hancockks/OpenSCAD_case/case_library.scad

// case_library.scad
// Parametric case/box library — plain OpenSCAD, no external includes (see hinge include below
// for the one exception: it pulls in ../OpenSCAD_hinge/hinge_library.scad, tagged so
// OpenSCAD-gui can auto-fetch it too).
//
// @github: morganp/OpenSCAD_hinge
include <../OpenSCAD_hinge/hinge_library.scad>

// ---------------------------------------------------------------------------
// Internal helpers
// ---------------------------------------------------------------------------

module _rounded_rect(l, w, r, fn=48) {
    rr = min(r, l/2, w/2);
    hull() {
        for (cx = [rr, l-rr]) for (cy = [rr, w-rr])
            translate([cx, cy]) circle(r=rr, $fn=fn);
    }
}

module _box_shell(length, width, height, wall, corner_r, fn) {
    difference() {
        linear_extrude(height=height) _rounded_rect(length, width, corner_r, fn);
        translate([wall, wall, wall])
            linear_extrude(height=height + 0.1) // extra overshoot avoids coplanar Boolean artifacts
                _rounded_rect(length - 2*wall, width - 2*wall, max(0.1, corner_r - wall), fn);
    }
}

module _dividers(length, width, height, wall, div_x, div_y, div_thickness) {
    inner_l = length - 2*wall;
    inner_w = width  - 2*wall;
    div_h   = height - wall - 0.1; // stop just below the rim to avoid coplanar skins
    if (div_x > 0) {
        step = inner_l / (div_x + 1);
        for (i = [1:div_x])
            translate([wall + step*i - div_thickness/2, wall, wall])
                cube([div_thickness, inner_w, div_h]);
    }
    if (div_y > 0) {
        step = inner_w / (div_y + 1);
        for (i = [1:div_y])
            translate([wall, wall + step*i - div_thickness/2, wall])
                cube([inner_l, div_thickness, div_h]);
    }
}

// Matching lid ribs close the headspace above body dividers so small parts cannot migrate.
// They overlap the lid floor by 0.1 mm for a robust union and leave div_gap at the seam.
// Keep a small clearance from the rebated front and side walls. The hinge-side ends
// meet the full-thickness inner wall because there is no latch rebate there.
module _lid_dividers(length, width, hb, hl, wall, div_x, div_y, div_thickness,
                     div_gap=0.2, edge_clearance=0.4) {
    inner_l = length - 2*wall;
    inner_w = width  - 2*wall;
    rib_l   = inner_l - 2*edge_clearance;
    rib_w   = inner_w - edge_clearance;
    rib_h   = max(0, hl - wall - div_gap + 0.1);
    z0      = hb + div_gap;
    if (div_x > 0) {
        step = inner_l / (div_x + 1);
        for (i = [1:div_x])
            translate([wall + step*i - div_thickness/2, wall + edge_clearance, z0])
                cube([div_thickness, rib_w, rib_h]);
    }
    if (div_y > 0) {
        step = inner_w / (div_y + 1);
        for (i = [1:div_y])
            translate([wall + edge_clearance, wall + step*i - div_thickness/2, z0])
                cube([rib_l, div_thickness, rib_h]);
    }
}

// 45-degree chamfer cutter along the back edge at y=w, z=z: a diamond prism whose
// cross-section is centered on the edge line, so subtracting it from either the body
// (solid below/inside) or the lid (solid above/inside) chamfers that part's rim edge.
module _hb_edge_chamfer(l, w, z, ch) {
    s = ch * 1.4143;
    translate([-1, w, z])
        rotate([45, 0, 0])
            translate([0, -s/2, -s/2])
                cube([l + 2, s, s]);
}

// Alignment/dust lip: the inner portion of the body wall carried up past the seam, flush
// with the wall's inner face — a shiplap joint with the rebated lid wall, so the lip is
// solid wall material, not a separate ring. Cut short of the back edge so nothing sits
// inside the hinge swing zone.
module _hb_lip(l, w, wall, lip_t, z, lip_h, y_max, corner_r, fn) {
    o = wall - lip_t;
    intersection() {
        translate([0, 0, z - 0.5]) // overlaps the wall top so lip and wall fuse
            linear_extrude(height=lip_h + 0.5)
                difference() {
                    translate([o, o])
                        _rounded_rect(l - 2*o, w - 2*o, max(0.1, corner_r - o), fn);
                    translate([wall, wall])
                        _rounded_rect(l - 2*wall, w - 2*wall,
                                      max(0.1, corner_r - wall), fn);
                }
        translate([-1, -1, z - 1]) cube([l + 2, y_max + 1, lip_h + 3]);
    }
}

// Snap ridge on the lip's front outer face: square bottom face retains the closed lid,
// chamfered top face cams the lid wall outward as it slides down over the lip.
module _hb_bump(l, wall, lip_t, z, lip_h, latch_w, latch_bump) {
    bh = max(0.6, min(3, lip_h - 1.2));
    z0 = z + max(0.6, (lip_h - bh)/2);
    yo = wall - lip_t; // lip outer face
    hull() {
        translate([l/2 - latch_w/2, yo - 0.01, z0])
            cube([latch_w, 0.02, bh]);
        translate([l/2 - latch_w/2, yo - latch_bump, z0])
            cube([latch_w, latch_bump, max(0.4, bh - latch_bump*1.5)]);
    }
}

// Body tray in closed-assembly coordinates: tub + dividers + lip + snap ridge + front ribs.
module _hb_body(l, w, hb, wall, corner_r, div_x, div_y, div_t,
                lip_h, lip_t, c, lip_ymax, latch_w, latch_bump,
                rib_xs, rib_w, rib_d, back_ch, fn) {
    difference() {
        union() {
            _box_shell(l, w, hb, wall, corner_r, fn);
            _dividers(l, w, hb, wall, div_x, div_y, div_t);
            _hb_lip(l, w, wall, lip_t, hb, lip_h, lip_ymax, corner_r, fn);
            _hb_bump(l, wall, lip_t, hb, lip_h, latch_w, latch_bump);
            for (x = rib_xs)
                translate([x - rib_w/2, -rib_d, 0])
                    cube([rib_w, rib_d + 0.01, hb - 0.2]);
        }
        if (back_ch > 0)
            _hb_edge_chamfer(l, w, hb, back_ch);
    }
}

// Lid tray in closed-assembly coordinates (opening down, spanning z in [hb, hb+hl]):
// shell + lip rebate + front/top ribs + latch groove + lid text + hinge-clearance chamfer.
module _hb_lid(l, w, hb, hl, wall, corner_r, c, lip_t, lip_ymax,
               lip_h, latch_w, latch_bump,
               div_x, div_y, div_t, div_gap, div_clearance,
               rib_xs, rib_w, rib_d, back_ch,
               txt, txt_size, txt_depth, txt_emboss, fn) {
    top   = hb + hl;
    bh    = max(0.6, min(3, lip_h - 1.2));
    z0    = hb + max(0.6, (lip_h - bh)/2);
    y_reb = wall - lip_t - c;   // rebated inner face over the lip engagement zone
    gd    = latch_bump - c;     // groove depth into the rebated wall
    difference() {
        union() {
            translate([0, 0, hb])
                difference() {
                    linear_extrude(height=hl) _rounded_rect(l, w, corner_r, fn);
                    translate([wall, wall, -0.05])
                        linear_extrude(height=hl - wall + 0.05)
                            _rounded_rect(l - 2*wall, w - 2*wall,
                                          max(0.1, corner_r - wall), fn);
                }
            for (x = rib_xs) {
                translate([x - rib_w/2, -rib_d, hb + 0.2])
                    cube([rib_w, rib_d + 0.01, hl - 0.2]);
                translate([x - rib_w/2, -rib_d, top - 0.01])
                    cube([rib_w, rib_d + w - 2, rib_d + 0.01]);
            }
            if (txt_emboss && len(txt) > 0)
                translate([l/2, w/2, top - 0.01])
                    linear_extrude(height=txt_depth + 0.01)
                        text(txt, size=txt_size, halign="center", valign="center");
        }
        // rebate: thin the lid wall's inner portion over the lip engagement zone so the
        // body's wall-lip slides up inside it (shiplap seam); restricted to where the lip
        // exists so the back wall around the hinge straps keeps full thickness
        intersection() {
            translate([0, 0, hb - 0.05])
                linear_extrude(height=lip_h + c + 0.15)
                    translate([y_reb, y_reb])
                        _rounded_rect(l - 2*y_reb, w - 2*y_reb,
                                      max(0.1, corner_r - y_reb), fn);
            translate([-1, -1, hb - 1])
                cube([l + 2, lip_ymax + c + 1.4, lip_h + c + 2]);
        }
        // latch groove in the rebated front wall face, mating the lip's snap ridge
        translate([l/2 - latch_w/2 - 0.3, y_reb - gd, z0 - 0.2])
            cube([latch_w + 0.6, gd + 0.01, bh + 0.5]);
        if (!txt_emboss && len(txt) > 0)
            translate([l/2, w/2, top - txt_depth])
                linear_extrude(height=txt_depth + 0.02)
                    text(txt, size=txt_size, halign="center", valign="center");
        if (back_ch > 0)
            _hb_edge_chamfer(l, w, hb, back_ch);
    }
    // Add after the rebate/groove cuts so the containment ribs keep their full height.
    _lid_dividers(l, w, hb, hl, wall, div_x, div_y, div_t, div_gap, div_clearance);
}

// Hinge leaves along the back seam, in closed-assembly coordinates. The hinge modules
// generate flat at Z=0 with the axis along Y; this reorients them so the mount plane lands
// at mount_y (the back face minus the recess depth, so the leaf plates sit inside the
// walls, outer face flush), the axis runs along X at the seam height, leaf2 straps into
// the body (below the seam) and leaf1 into the lid (above it).
module _hb_hinges(type, xs, mount_y, hb, len_each, leaf_w, strap_w, kod, cod,
                  pin, pin_c, leaf_t, parts, fn) {
    for (x = xs)
        translate([x, mount_y, hb])
            rotate([-90, 0, 0])
                rotate([0, 0, 90]) {
                    if (type == "crate")
                        crate_hinge(leaf_length=len_each, strap_width=strap_w,
                                    strap_thickness=leaf_t,
                                    knuckle_od=cod, knuckle_count=3, axis_height=0,
                                    pin_d=pin, pin_clearance=pin_c, knuckle_gap=0.4,
                                    screws_per_leaf=0, print_pin=false, parts=parts, fn=fn);
                    else if (type == "flush") {
                        // odd knuckle count at ~8mm pitch, like piano_hinge, so the
                        // lid leaf owns both end knuckles and the pin stays captive
                        raw = max(3, round(len_each / 8));
                        flush_knuckle_hinge(leaf_length=len_each, leaf_width=leaf_w,
                                            knuckle_od=kod,
                                            knuckle_count=raw % 2 == 0 ? raw + 1 : raw,
                                            pin_d=pin, pin_clearance=pin_c,
                                            knuckle_gap=0.3, scallop_clearance=0.3,
                                            integral_pin=false, print_pin=false,
                                            parts=parts, fn=fn);
                    }
                    else if (type == "piano")
                        piano_hinge(length=len_each, leaf_width=leaf_w, leaf_thickness=leaf_t,
                                    knuckle_od=kod, pin_d=pin, pin_clearance=pin_c,
                                    integral_pin=false, print_pin=false, parts=parts, fn=fn);
                    else
                        knuckle_hinge(leaf_length=len_each, leaf_width=leaf_w,
                                      leaf_thickness=leaf_t, knuckle_od=kod, knuckle_count=5,
                                      pin_d=pin, pin_clearance=pin_c, knuckle_gap=0.3,
                                      integral_pin=false, print_pin=false, parts=parts, fn=fn);
                }
}

// Cylinder(s) along the hinge axis, one per hinge span: used both as the knuckle relief
// notch cut from the mating rims (r = barrel radius + clearance) and as the top-level pin
// bore (r = pin radius + clearance) cut after the leaves are unioned in, so wall material
// never refills the embedded back half of the bore.
module _hb_axis_cyl(xs, len_each, y, z, r, fn) {
    if (r > 0)
        for (x = xs)
            translate([x - len_each/2 - 0.5, y, z])
                rotate([0, 90, 0])
                    cylinder(h=len_each + 1, r=r, $fn=fn);
}

// ---------------------------------------------------------------------------
// hinged_box — two-tray hinged box: body tray + lid tray joined by pinned hinges
// across the back seam, snap latch on the front.
//
// Two printed parts (body upright, lid beside it opening up), no supports. Each part
// carries its own fused hinge leaf; drop in the pin to assemble. Piano/knuckle hinges
// take a length of 1.75mm filament as the pin, the crate hinge takes a 4mm rod or the
// printed pins emitted next to the parts.
//
// hinge_type:
//   "piano"   — one continuous knuckle hinge across the back seam (default; robust,
//               even load spread, filament pin).
//   "knuckle" — hinge_count discrete knuckle hinges (lighter, classic look).
//   "crate"   — chunky raised-lug crate hinges for the rugged/ammo-box look; pair with
//               ribs > 0. Lid opens past 180 degrees.
//   "flush"   — fully hidden hinge (flush_knuckle_hinge): pivot centered inside the back
//               wall, knuckle OD equals the wall thickness, zero protrusion; works down to
//               2mm walls. The leaf plates are full wall thickness and run right up to the
//               axis, with a scallop along each inner edge nesting the other leaf's
//               knuckles, so the lid opens flat to 180 degrees (closes flat, folds flat).
//               Pin is a 0.8mm rod/wire slid in along the
//               seam from past the left corner (the axis line runs through open air behind
//               the corner rounding, so no tunnel is needed); a plug fused inside the far
//               knuckle makes that end blind, and a small printed cap glues into the first
//               knuckle's bore to close the entry — both coaxial, so the swing never sees
//               them. A cove relief along the seam lets the rims swing past the buried axis.
//
// An alignment lip on the body rim registers the closed lid; a snap ridge on the lip's
// front face clicks into a groove inside the lid wall. Clearances are a best-effort
// starting point — verify fit and tune lid_clearance / latch_bump for your printer.
//
// Origin: box centered on the XY origin, base at Z=0, hinge on the +Y edge (per this
// repo's conventions). pose="closed" previews the assembled box for fit checks.
// ---------------------------------------------------------------------------
module hinged_box(
    length          = 120,
    width           = 80,
    height          = 40,     // body tray OUTER height, bed to seam, includes the floor wall
    lid_depth       = 15,     // lid tray OUTER height above the seam, includes the lid top wall
    wall            = 2.4,
    corner_r        = 6,
    div_x           = 0,
    div_y           = 0,
    lid_dividers    = false,  // true = matching ribs under the lid to retain small parts
    lid_divider_clearance = 0.4, // clearance at rebated front/side walls; hinge side stays flush
    div_thickness   = 1.6,
    hinge_type      = "piano", // "piano" | "knuckle" | "crate"
    hinge_count     = 2,      // knuckle/crate: number of discrete hinges
    hinge_len       = 30,     // knuckle/crate: leaf length along X per hinge
    hinge_margin    = 8,      // hinge inset from each end along X
    knuckle_od      = 0,      // piano/knuckle barrel OD; 0 = auto (max(5, 2*wall))
    pin_d           = 0,      // hinge pin dia; 0 = auto (1.75 filament, 4 for crate)
    pin_clearance   = 0.25,
    leaf_thickness  = 2,      // hinge leaf/strap thickness, recessed into the back walls
                              // (clamped to wall - 0.4 so the leaf stays inside the wall)
    lip_h           = 4,      // alignment lip height above the seam
    lid_clearance   = 0.3,    // radial clearance between lip and lid inner wall
    latch_w         = 14,     // width of the snap latch, centered on the front
    latch_bump      = 0.8,    // snap ridge protrusion from the lip face
    ribs            = 0,      // rugged-look vertical ribs on the front + over the lid top
    rib_w           = 0,      // rib width; 0 = auto (2.5*wall)
    rib_depth       = 0,      // rib protrusion; 0 = auto (wall)
    lid_text        = "",
    lid_text_size   = 10,
    lid_text_depth  = 0.6,
    lid_text_emboss = false,  // true = raised (prints face-down: prefer deboss on FDM)
    pose            = "print", // "print" = both parts flat on the bed | "closed" = assembled
    fn              = 48
) {
    l = length; w = width; hb = height; hl = lid_depth; t = wall; c = lid_clearance;
    lid_div_x = lid_dividers ? div_x : 0;
    lid_div_y = lid_dividers ? div_y : 0;
    crate = hinge_type == "crate";
    flush = hinge_type == "flush";
    kod   = flush ? t : (knuckle_od > 0 ? knuckle_od : max(5, 2*t));
    cod   = 9;                                    // crate barrel OD
    pin   = pin_d > 0 ? pin_d
          : flush ? 0.8                           // 0.8mm rod/wire, works down to 2mm walls
          : crate ? 4 : 1.75;
    pinc  = flush ? min(pin_clearance, 0.15) : pin_clearance; // thin flush knuckles need a
                                                  // snugger bore to keep any skin around it
    edge  = crate ? cod/2 + 0.4 : kod/2 + 0.3;    // barrel-to-strap edge, per hinge module
    leaf_te = min(leaf_thickness, t - 0.4);       // recessed leaf thickness; the flush hinge
                                                  // ignores it (its plates are kod thick)
    leafw = flush ? max(t, min(10, hl - 0.4))     // flush plate: axis to outer edge, embeds
                                                  // full-depth in the back wall
          : max(1.5, min(10, hl - edge - 0.4));   // piano/knuckle leaf width, fits lid wall
    strapw = max(3, min(16, hl - edge - 0.4));    // crate strap width, fits lid wall
    ch    = (crate || flush) ? 0 : 0.8; // rim chamfer to clear the low external piano barrel
    lip_t = min(1, t/2);      // lip = inner portion of the wall: max 1mm or 50% of the wall
    lb    = min(latch_bump, c + max(0.2, t - lip_t - c - 0.4)); // clamp the snap ridge so its
                              // groove leaves >=0.4 skin in the rebated lid wall
    lip_he = max(0.8, min(lip_h, hl - t - c - 0.2)); // lip + rebate fit inside the lid cavity
    lip_ymax = w - t - c - (lip_he + 2*t);        // keep the lip out of the hinge swing zone
    rw    = rib_w > 0 ? rib_w : 2.5*t;
    rd    = rib_depth > 0 ? rib_depth : t;
    rib_m = max(corner_r, rw) + 2;
    rib_xs = ribs <= 0 ? [] : [for (i = [0:ribs-1]) rib_m + (l - 2*rib_m)*(i + 0.5)/ribs];
    piano_like = hinge_type == "piano" || flush;
    xs    = (piano_like || hinge_count <= 1) ? [l/2]
          : [for (i = [0:hinge_count-1])
                hinge_margin + hinge_len/2
                + i*(l - 2*hinge_margin - hinge_len)/(hinge_count - 1)];
    len_each = piano_like ? l - 2*hinge_margin : hinge_len;
    mount_y  = flush ? w - t : w - leaf_te;       // leaf mount plane inside the wall
    y_ax     = mount_y + (crate ? cod : kod/2);   // flush: axis mid-wall, zero protrusion
    relief_r = crate ? 0 : flush ? t : kod/2 + 0.4; // rim relief around the barrel/knuckles;
                                                  // flush needs a full cove or the lid binds
    // Flush cove extent: the cove is needed wherever wall material sits within one
    // wall-thickness of the buried axis. Nearest corner material lies (recession - t/2)
    // from the axis, so the cove runs into the corners until the surface has receded 1.5t.
    cove0    = corner_r > 1.5*t
             ? corner_r - sqrt(corner_r*corner_r - (corner_r - 1.5*t)*(corner_r - 1.5*t))
             : 0;
    rel_xs   = flush ? [l/2] : xs;                // flush: relieve the whole straight seam,
    rel_len  = flush ? l - 2*cove0 - 1 : len_each;// since the rim corners swing past the axis
    bore_r   = pin/2 + pinc + 0.05;               // top-level pin bore radius
    // Flush pin retention: beyond the cove the axis line passes through open air behind the
    // rounded corner, so the rod slides straight in from the left with no tunnel. A plug
    // fused inside the far knuckle makes that end blind; the printed cap glues into the
    // first knuckle's bore to close the near end. Both are coaxial, so they never touch the
    // swing. Rod lives entirely inside the knuckles, between cap stem and plug.
    plug_x   = l - hinge_margin - 1.8;            // blind plug position, inside the far knuckle
    rod_len  = l - 2*hinge_margin - 6;            // rod span between cap stem and plug
    y_off    = 2*w + 15;                          // lid print position gap

    echo(str("hinged_box: body ", l, "x", w, "x", hb, "mm + lid ", l, "x", w, "x", hl,
             "mm (outer), hinge=", hinge_type, ", pin d=", pin,
             crate ? "mm (printed pins beside the parts)"
                   : flush ? "mm (use a rod/wire of that dia as the pin, e.g. a paperclip)"
                           : "mm (use a length of 1.75mm filament as the pin)"));
    if (flush)
        echo(str("hinged_box flush hinge: lid opens flat to 180 degrees. Cut the ", pin,
                 "mm rod to ~", round(rod_len), "mm, slide it in along the seam from past",
                 " the left corner until it stops (the far end is blind), then glue the",
                 " printed cap's stem into the first knuckle's bore behind it."));
    echo(str("hinged_box internal: footprint ", l - 2*t, "x", w - 2*t,
             "mm, body cavity depth ", hb - t,
             "mm, closed clearance floor-to-lid ", hb + hl - 2*t, "mm"));

    translate([-l/2, -w/2, 0]) {
        // body: notch the rim around the foreign (lid-side) knuckles, fuse the body leaf,
        // then bore the pin channel through leaf and wall together
        difference() {
            union() {
                difference() {
                    _hb_body(l, w, hb, t, corner_r, div_x, div_y, div_thickness,
                             lip_he, lip_t, c, lip_ymax, latch_w, lb,
                             rib_xs, rw, rd, ch, fn);
                    _hb_axis_cyl(rel_xs, rel_len, y_ax, hb, relief_r, fn);
                }
                _hb_hinges(hinge_type, xs, mount_y, hb, len_each, leafw, strapw, kod, cod,
                           pin, pinc, leaf_te, "leaf2", fn);
            }
            _hb_axis_cyl([l/2], l + 1, y_ax, hb, flush ? 0 : bore_r, fn); // pin bore (flush bores via the knuckles only)
        }

        if (pose == "closed") {
            difference() {
                union() {
                    difference() {
                        _hb_lid(l, w, hb, hl, t, corner_r, c, lip_t, lip_ymax, lip_he,
                                latch_w, lb, lid_div_x, lid_div_y, div_thickness, 0.2,
                                lid_divider_clearance, rib_xs, rw, rd, ch,
                                lid_text, lid_text_size, lid_text_depth, lid_text_emboss, fn);
                        _hb_axis_cyl(rel_xs, rel_len, y_ax, hb, relief_r, fn);
                    }
                    _hb_hinges(hinge_type, xs, mount_y, hb, len_each, leafw, strapw, kod, cod,
                               pin, pinc, leaf_te, "leaf1", fn);
                    if (flush) // blind plug fused inside the far knuckle: rod cannot slide out
                        translate([plug_x, y_ax, hb])
                            rotate([0, 90, 0])
                                cylinder(h=1.7, r=bore_r + 0.15, $fn=fn);
                }
                _hb_axis_cyl([l/2], l + 1, y_ax, hb, flush ? 0 : bore_r, fn); // pin bore (flush bores via the knuckles only)
            }
            for (x = xs) // pins shown in place
                translate([x - len_each/2, y_ax, hb])
                    rotate([0, 90, 0])
                        cylinder(h=len_each, r=pin/2, $fn=fn);
        } else {
            // lid printed opening-up beyond the body in +Y, its hinge leaf riding along
            translate([0, y_off, hb + hl])
                rotate([180, 0, 0])
                    difference() {
                        union() {
                            difference() {
                                _hb_lid(l, w, hb, hl, t, corner_r, c, lip_t, lip_ymax,
                                        lip_he, latch_w, lb, lid_div_x, lid_div_y,
                                        div_thickness, 0.2, lid_divider_clearance,
                                        rib_xs, rw, rd, ch,
                                        lid_text, lid_text_size, lid_text_depth,
                                        lid_text_emboss, fn);
                                _hb_axis_cyl(rel_xs, rel_len, y_ax, hb, relief_r, fn);
                            }
                            _hb_hinges(hinge_type, xs, mount_y, hb, len_each, leafw, strapw,
                                       kod, cod, pin, pinc, leaf_te, "leaf1", fn);
                            if (flush) // blind plug fused inside the far knuckle
                                translate([plug_x, y_ax, hb])
                                    rotate([0, 90, 0])
                                        cylinder(h=1.7, r=bore_r + 0.15, $fn=fn);
                        }
                        _hb_axis_cyl([l/2], l + 1, y_ax, hb, flush ? 0 : bore_r, fn); // pin bore (flush bores via the knuckles only)
                    }
            if (crate) // printed pins, one per hinge, lying in front of the body
                for (i = [0:len(xs)-1])
                    translate([l/2 - (len_each - 1)/2, -rd - 8 - i*(pin + 4), pin/2])
                        rotate([0, 90, 0])
                            cylinder(h=len_each - 1, r=pin/2, $fn=fn);
            if (flush) // glue-in cap: stem glues 4mm into the first knuckle's bore behind
                       // the rod, small coaxial head sits against the knuckle end face
                translate([-8, -8, 0]) {
                    cylinder(h=1, r=min(kod/2 - 0.15, 0.85), $fn=fn);
                    cylinder(h=5, r=bore_r - 0.12, $fn=fn);
                }
        }
    }
}
