hancockks/OpenSCAD_case/(commit log)

2026-09-27 fix: prevent divider skins and add optional lid ribs
    - Oversize the inner shell subtraction by 0.1 mm
    - Lower body dividers by 0.1 mm to avoid coplanar slicing artifacts
    - Add optional matching lid dividers
    - Add configurable 0.4 mm front/side clearance
    - Extend lid ribs fully to the hinge-side inner wall
    [case_library.scad]
2026-09-27 Add OpenSCAD case customizer file
    [case.scad]
